hjltu/wemos-wifi-controller/img/mp-wemos-01-jun-18.png

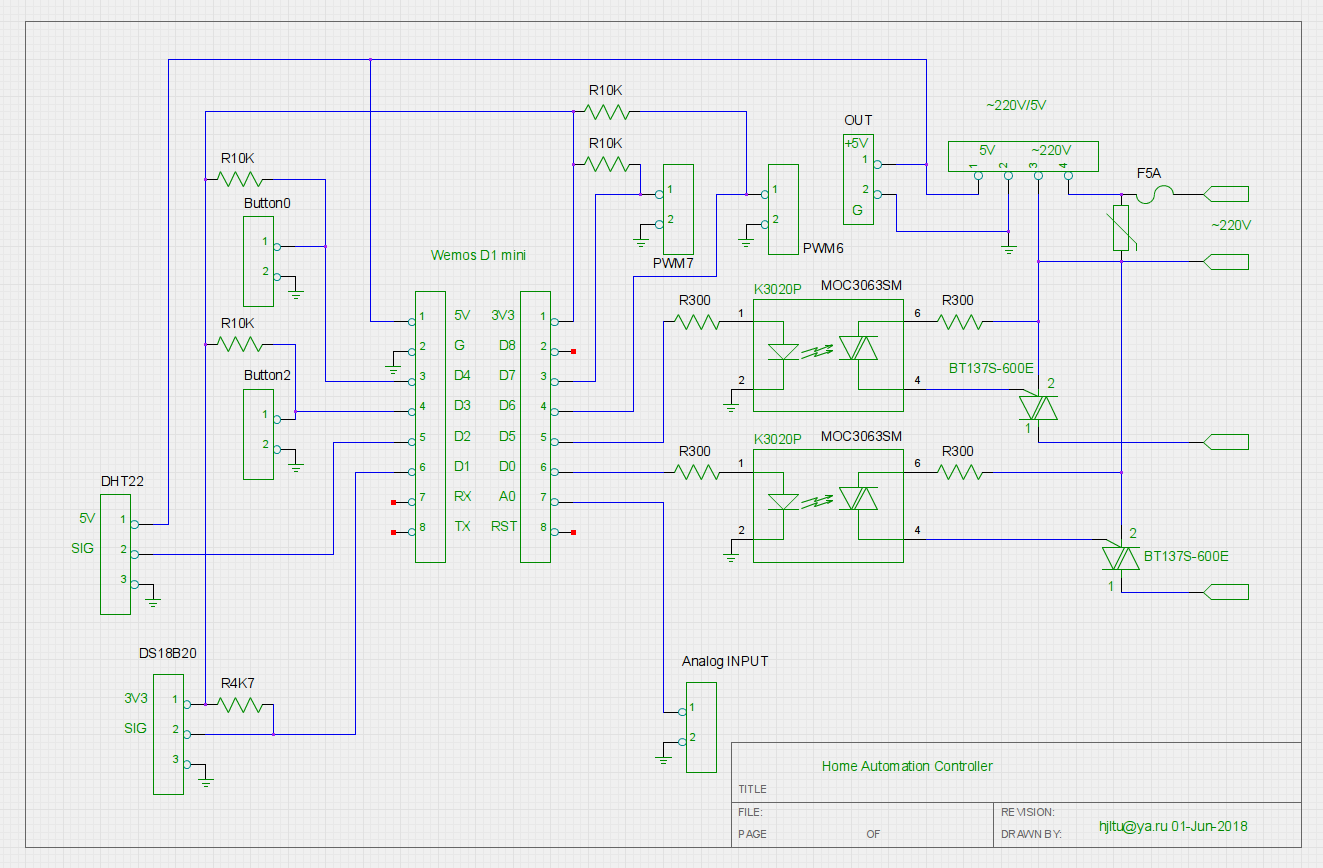
img/mp-wemos-01-jun-18.png
