hjltu/wemos-wifi-controller/img/my-pcb.png

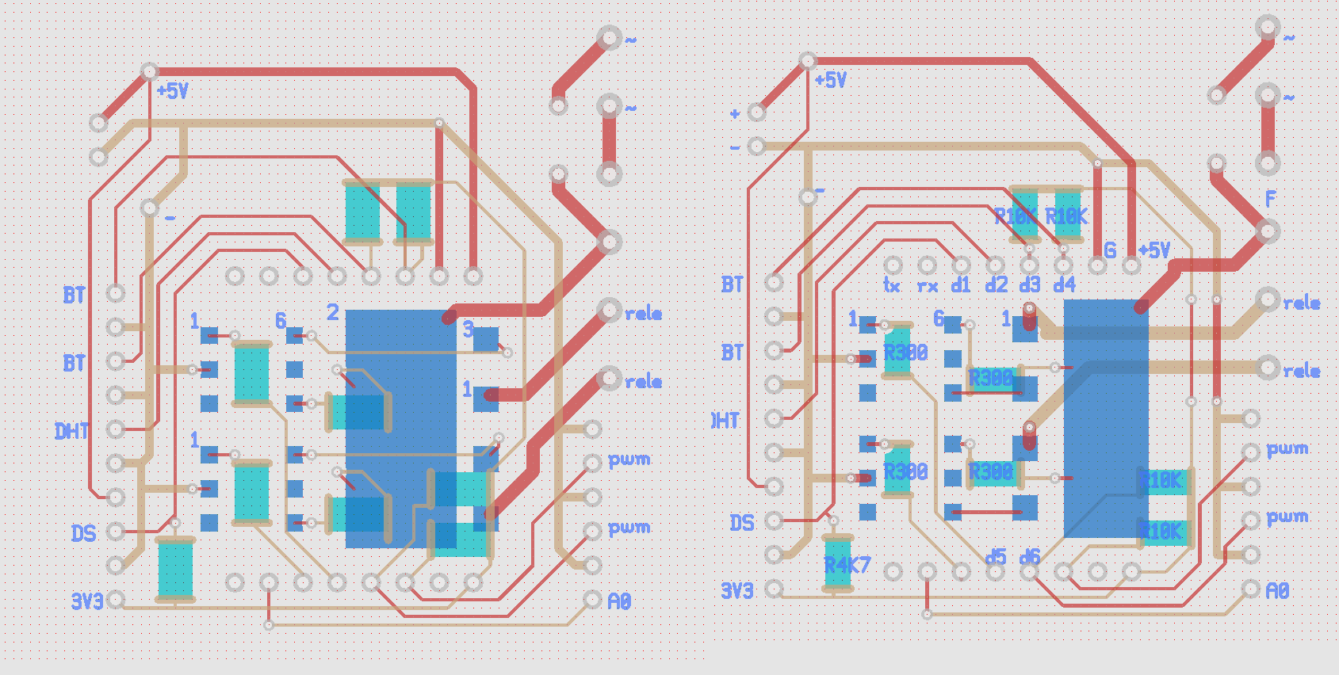
img/my-pcb.png
