hjltu/wemos-wifi-controller/img/wemos-17-mar-18.png

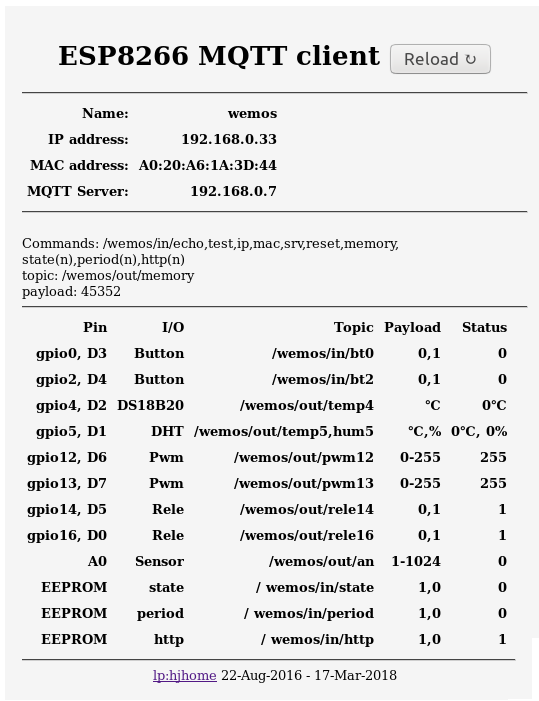
img/wemos-17-mar-18.png
