hjltu/wemos-wifi-controller/img/wemos-26-nov-17.png

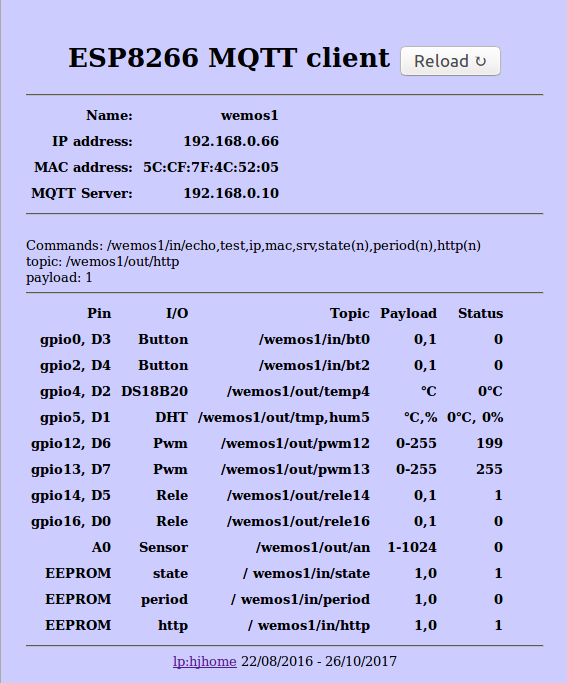
img/wemos-26-nov-17.png
