hjltu/wemos-wifi-controller/kicad/wemos.kicad_sch

## KiCad design kicad/wemos.kicad_sch (2026-09-12)

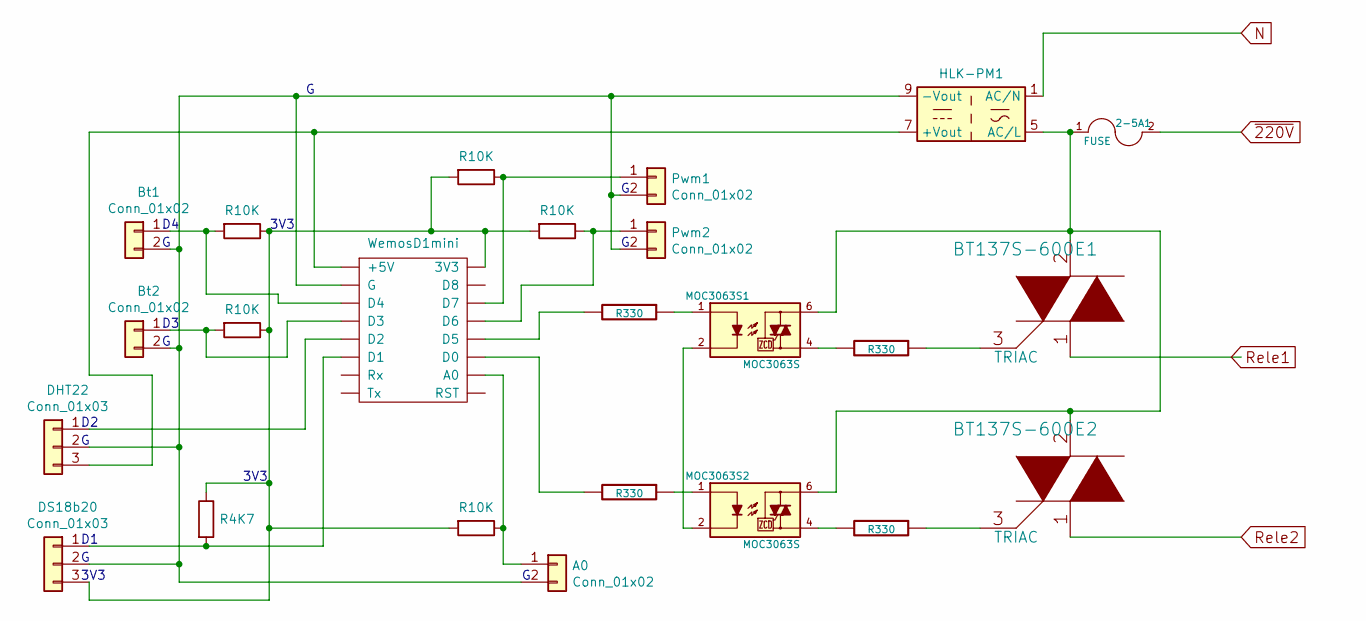
[picture p5: schematic wemos.kicad_sch]

Parts:
2-5A1: FUSE
A0: Conn_01x02
BT137S-600E1, BT137S-600E2: TRIAC
Bt1, Bt2: Conn_01x02
DHT22: Conn_01x03
DS18b20: Conn_01x03
HLK-PM1: HLK-PM01
MOC3063S1, MOC3063S2: MOC3063S
Pwm1, Pwm2: Conn_01x02
R1: R4K7
R2, R3, R4, R5, R6: R10K
R7, R8, R9, R10: R330
U1: WemosD1mini

Connections:
N: HLK-PM1.1 (AC/N)
unnamed: 2-5A1.1, BT137S-600E1.2, BT137S-600E2.2, HLK-PM1.5 (AC/L), MOC3063S1.6, MOC3063S2.6
unnamed: A0.1, R5.1, U1.~
unnamed: A0.2, Bt1.2, Bt2.2, DHT22.2, DS18b20.2, HLK-PM1.9 (-Vout), Pwm1.2, Pwm2.2, U1.~
unnamed: BT137S-600E1.3, R9.1
unnamed: BT137S-600E2.3, R10.1
unnamed: Bt1.1, R2.2, U1.~
unnamed: Bt2.1, R3.2, U1.~
unnamed: DHT22.1, U1.~
unnamed: DHT22.3, HLK-PM1.7 (+Vout), U1.~
unnamed: DS18b20.1, R1.2, U1.~
unnamed: DS18b20.3, R1.1, R2.1, R3.1, R4.2, R5.2, R6.2, U1.~
unnamed: MOC3063S1.1, R7.1
unnamed: MOC3063S1.2, MOC3063S2.2
unnamed: MOC3063S1.4, R9.2
unnamed: MOC3063S2.1, R8.1
unnamed: MOC3063S2.4, R10.2
unnamed: Pwm1.1, R4.1, U1.~
unnamed: Pwm2.1, R6.1, U1.~
unnamed: R7.2, U1.~
unnamed: R8.2, U1.~
Rele2: BT137S-600E2.1
~220V: 2-5A1.2

Notes on the sheet:
3V3
