hjltu/wemos-wifi-controller/(commit log)

2026-09-04 add pid controller
2026-09-11 fix pid, update documentation
    [wemos_automation.ino]
2026-09-12 add kicad files
    [wemos.kicad_pcb, wemos.kicad_sch]
2026-09-25 fix wifi mode switch
    [wemos_automation.ino]
2026-09-25 fix reboot loop
    http GET: /?topic_param=reboot&payload_param=0
    [wemos_automation.ino]
